seuros/epdiy-esp-idf-6/hardware/epaper-breakout/tp4056/charger_stepup.kicad_pcb

## KiCad design hardware/epaper-breakout/tp4056/charger_stepup.kicad_pcb (2025-03-20)

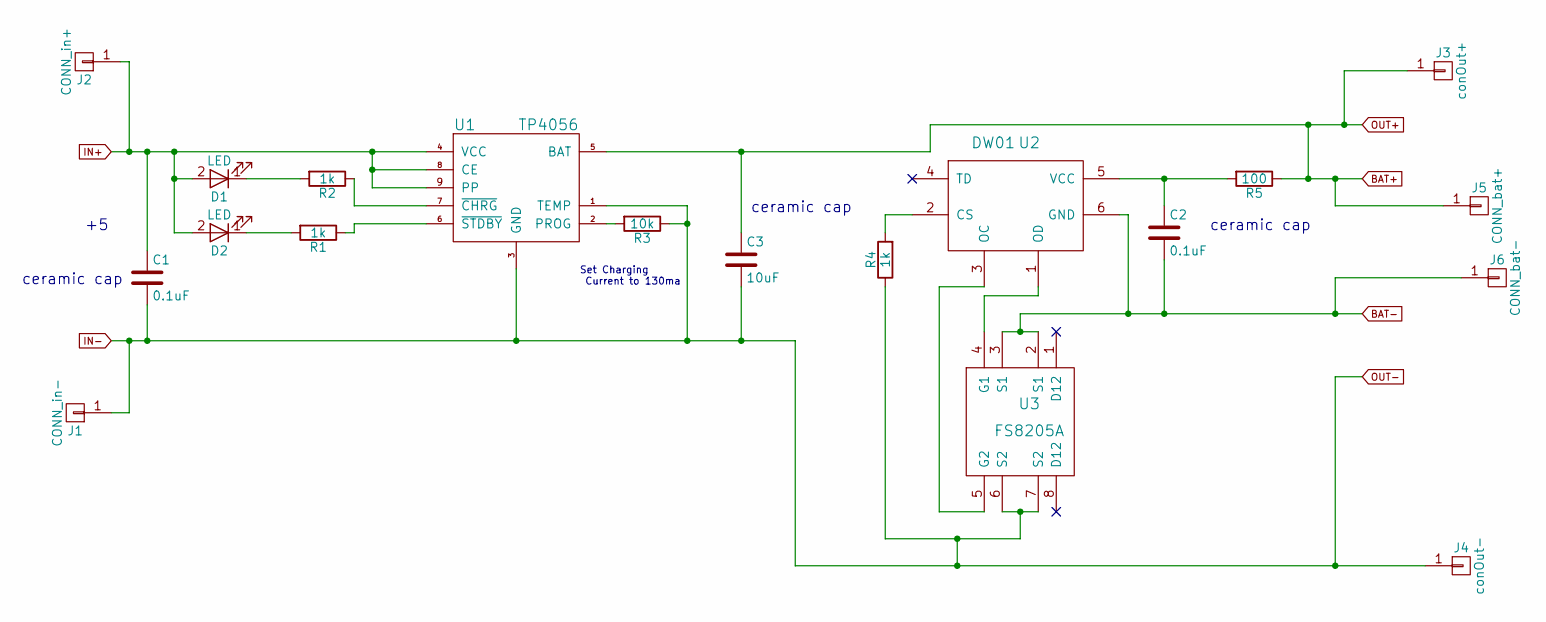
[picture p1: schematic charger_stepup.sch]

Parts:
C1, C2: 0.1uF; C_0805_HandSoldering
C3: 10uF; C_0805_HandSoldering
D1, D2: LED; LED_0603_HandSoldering
J1: CONN_in-; Pin_Header_Straight_1x01_Pitch2.54mm
J2: CONN_in+; Pin_Header_Straight_1x01_Pitch2.54mm
J3: conOut+; Pin_Header_Straight_1x01_Pitch2.54mm
J4: conOut-; Pin_Header_Straight_1x01_Pitch2.54mm
J5: CONN_bat+; Pin_Header_Straight_1x01_Pitch2.54mm
J6: CONN_bat-; Pin_Header_Straight_1x01_Pitch2.54mm
R1, R2, R4: 1k; R_0603_HandSoldering
R3: 10k; R_0603_HandSoldering
R5: 100; R_0603_HandSoldering
U1: TP4056; TP4056_SOP-8-PP
U2: DW01; SOT-23-6_Handsoldering
U3: FS8205A; TSSOP-8_4.4x3mm_Pitch0.65mm

Connections:
BAT+: C3.1, J3.1, J5.1, R5.1, U1.5 (BAT)
BAT-: C2.2, J6.1, U2.6 (GND), U3.2 (S1), U3.3 (S1)
IN+: C1.1, D1.2 (A), D2.2 (A), J2.1, U1.4 (VCC), U1.8 (CE), U1.9 (PP)
IN-: C1.2, C3.2, J1.1, J4.1, R3.1, R4.1, U1.1 (TEMP), U1.3 (GND), U3.6 (S2), U3.7 (S2)
unnamed: C2.1, R5.2, U2.5 (VCC)
unnamed: D1.1 (K), R2.2
unnamed: D2.1 (K), R1.2
unnamed: R1.1, U1.6 (~STDBY)
unnamed: R2.1, U1.7 (~CHRG)
unnamed: R3.2, U1.2 (PROG)
unnamed: R4.2, U2.2 (CS)
unnamed: U2.1 (OD), U3.4 (G1)
unnamed: U2.3 (OC), U3.5 (G2)

Notes on the sheet:
Set Charging Current to 130ma
ceramic cap

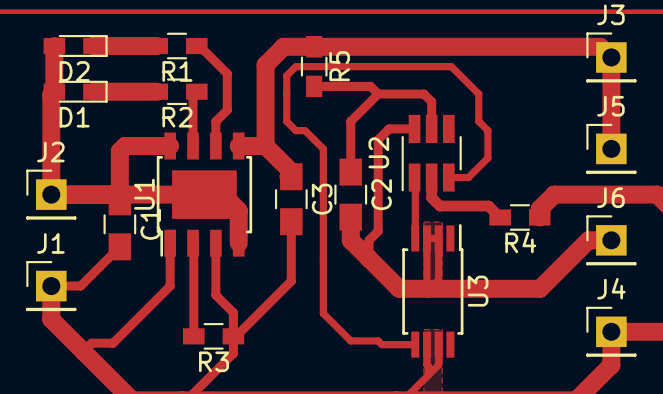
[picture p2: board charger_stepup.kicad_pcb from above]

Board: 2 copper layers, 19 parts (0 on the bottom side), 13 nets.
