seuros/epdiy-esp-idf-6/hardware/extension-40_to_PCB_test/extension-cable.kicad_pcb

## KiCad design hardware/extension-40_to_PCB_test/extension-cable.kicad_pcb (2023-10-25)

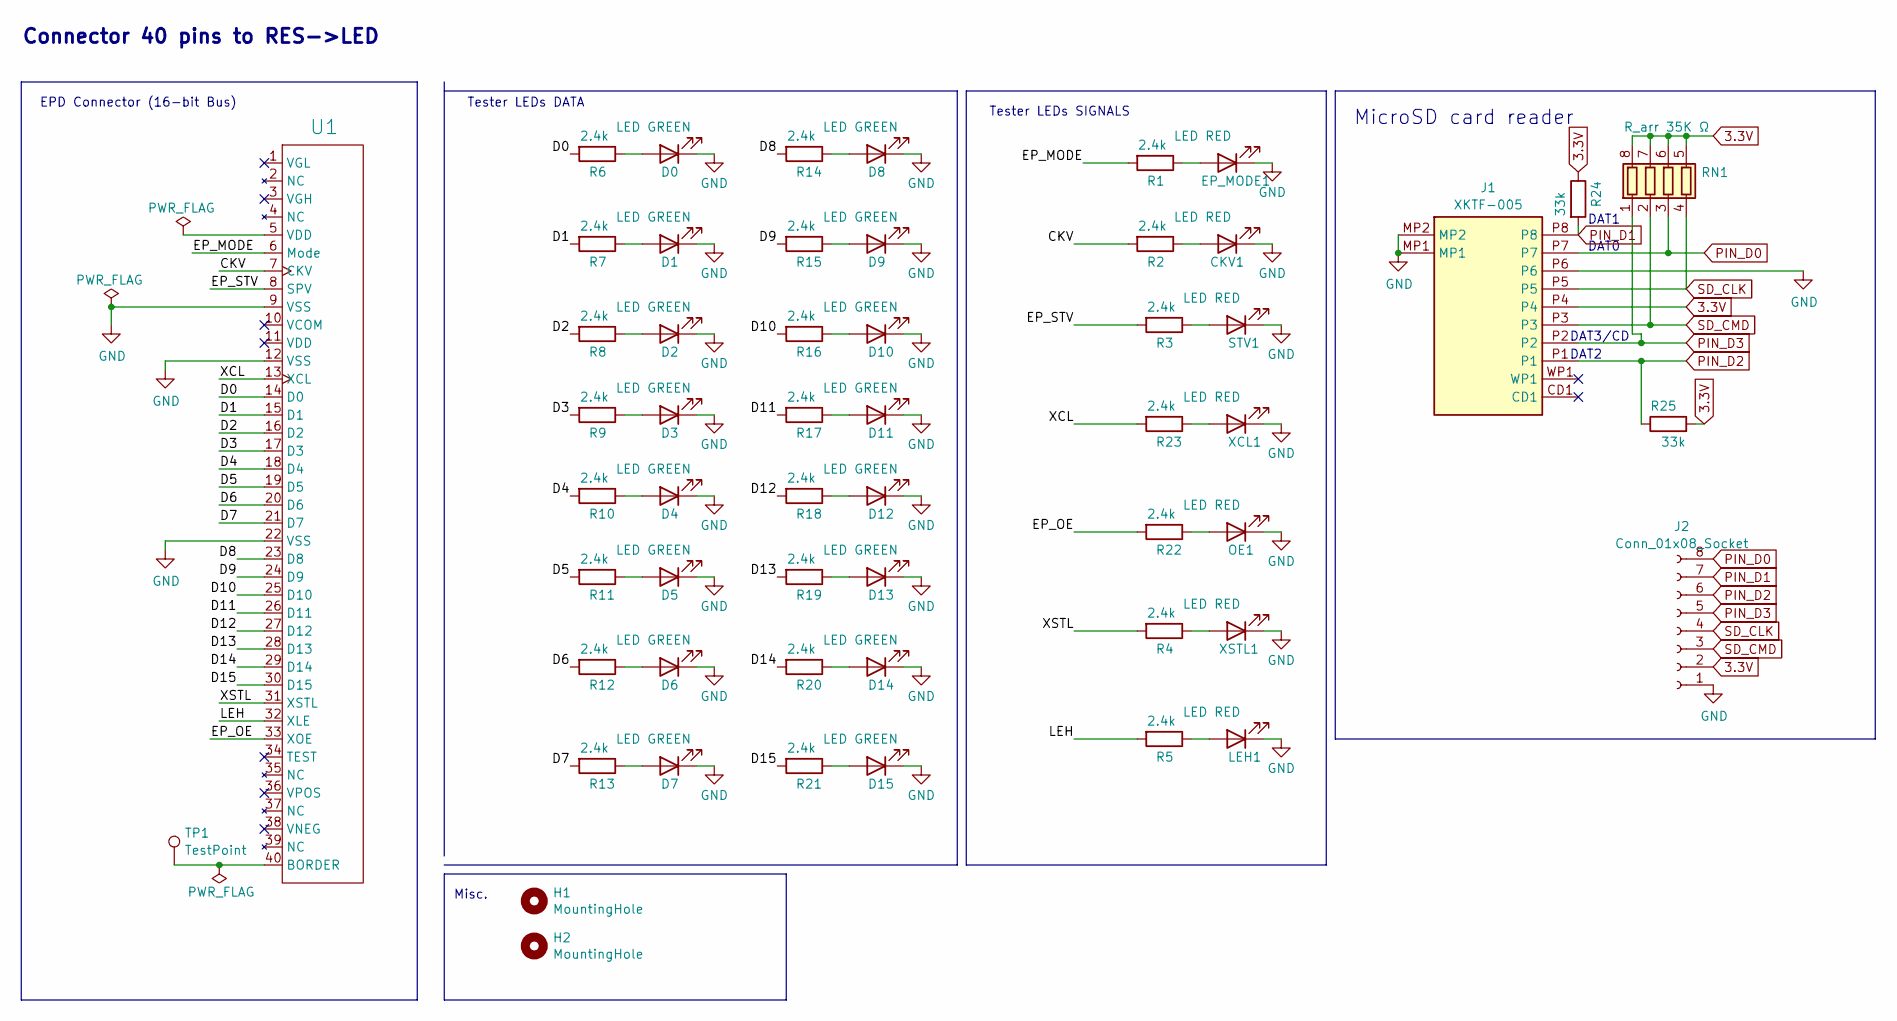
[picture p4: schematic extension-cable.kicad_sch, 40 pins to 16 bit signals tester (16 data IO + LEH,etc)]

Parts:
CKV1: LED RED; LED_0805_2012Metric; LCSC C84256
D0, D1, D2, D3, D4, D5, D6, D7, D8, D9, D10, D11, D12, D13, D14, D15: LED GREEN; LED_0805_2012Metric; LCSC C2297
EP_MODE1: LED RED; LED_0805_2012Metric; LCSC C84256
H1, H2: MountingHole; MountingHole_2.2mm_M2
J1: XKTF-005; XKTF005-SD; Manufacturer_Part_Number XKTF-005; LCSC C2689687
J2: Conn_01x08_Socket; PinSocket_1x08_P2.54mm_Vertical
LEH1: LED RED; LED_0805_2012Metric; LCSC C84256
OE1: LED RED; LED_0805_2012Metric; LCSC C84256
R1, R2, R3, R4, R5, R6, R7, R8, R9, R10, R11, R12, R13, R14, R15, R16, R17, R18, R19, R20, R21, R22, R23: 2.4k; R_0603_1608Metric; LCSC C22940
R24, R25: 33k; R_0603_1608Metric; LCSC C4216
RN1: R_arr 35K Ω; SMT_F392JTCE_UNR_SD-pullup; LCSC C425297
STV1: LED RED; LED_0805_2012Metric; LCSC C84256
TP1: TestPoint; TestPoint_Pad_2.0x2.0mm
U1: ED078KH6; FH1240S05SH55; LCSC C202114
XCL1: LED RED; LED_0805_2012Metric; LCSC C84256
XSTL1: LED RED; LED_0805_2012Metric; LCSC C84256

Connections:
3.3V: J1.P4, J2.2, R24.1, R25.2, RN1.5 (R4.2), RN1.6 (R3.2), RN1.7 (R2.2), RN1.8 (R1.2)
/CKV: R2.2, U1.7 (CKV)
/D0: R6.2, U1.14 (D0)
/D1: R7.2, U1.15 (D1)
/D2: R8.2, U1.16 (D2)
/D3: R9.2, U1.17 (D3)
/D4: R10.2, U1.18 (D4)
/D5: R11.2, U1.19 (D5)
/D6: R12.2, U1.20 (D6)
/D7: R13.2, U1.21 (D7)
/D8: R14.2, U1.23 (D8)
/D9: R15.2, U1.24 (D9)
/D10: R16.2, U1.25 (D10)
/D11: R17.2, U1.26 (D11)
/D12: R18.2, U1.27 (D12)
/D13: R19.2, U1.28 (D13)
/D14: R20.2, U1.29 (D14)
/D15: R21.2, U1.30 (D15)
/EP_MODE: R1.2, U1.6 (Mode)
/EP_OE: R22.2, U1.33 (XOE)
/EP_STV: R3.2, U1.8 (SPV)
/LEH: R5.2, U1.32 (XLE)
/XCL: R23.2, U1.13 (XCL)
/XSTL: R4.2, U1.31 (XSTL)
unnamed: CKV1.2 (A), R2.1
unnamed: D0.2 (A), R6.1
unnamed: D1.2 (A), R7.1
unnamed: D2.2 (A), R8.1
unnamed: D3.2 (A), R9.1
unnamed: D4.2 (A), R10.1
unnamed: D5.2 (A), R11.1
unnamed: D6.2 (A), R12.1
unnamed: D7.2 (A), R13.1
unnamed: D8.2 (A), R14.1
unnamed: D9.2 (A), R15.1
unnamed: D10.2 (A), R16.1
unnamed: D11.2 (A), R17.1
unnamed: D12.2 (A), R18.1
unnamed: D13.2 (A), R19.1
unnamed: D14.2 (A), R20.1
unnamed: D15.2 (A), R21.1
unnamed: EP_MODE1.2 (A), R1.1
unnamed: LEH1.2 (A), R5.1
unnamed: OE1.2 (A), R22.1
unnamed: R3.1, STV1.2 (A)
unnamed: R23.1, XCL1.2 (A)
unnamed: R4.1, XSTL1.2 (A)
PIN_D0: J1.P7, J2.8, RN1.3 (R3.1)
PIN_D1: J1.P8, J2.7, R24.2
PIN_D2: J1.P1, J2.6, R25.1
PIN_D3: J1.P2, J2.5, RN1.1 (R1.1)
SD_CLK: J1.P5, J2.4, RN1.4 (R4.1)
SD_CMD: J1.P3, J2.3, RN1.2 (R2.1)

Notes on the sheet:
DAT0
Tester LEDs SIGNALS
MicroSD card reader
Misc.
Tester LEDs DATA
Connector 40 pins to RES->LED
EPD Connector (16-bit Bus)
DAT1
DAT3/CD
DAT2

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
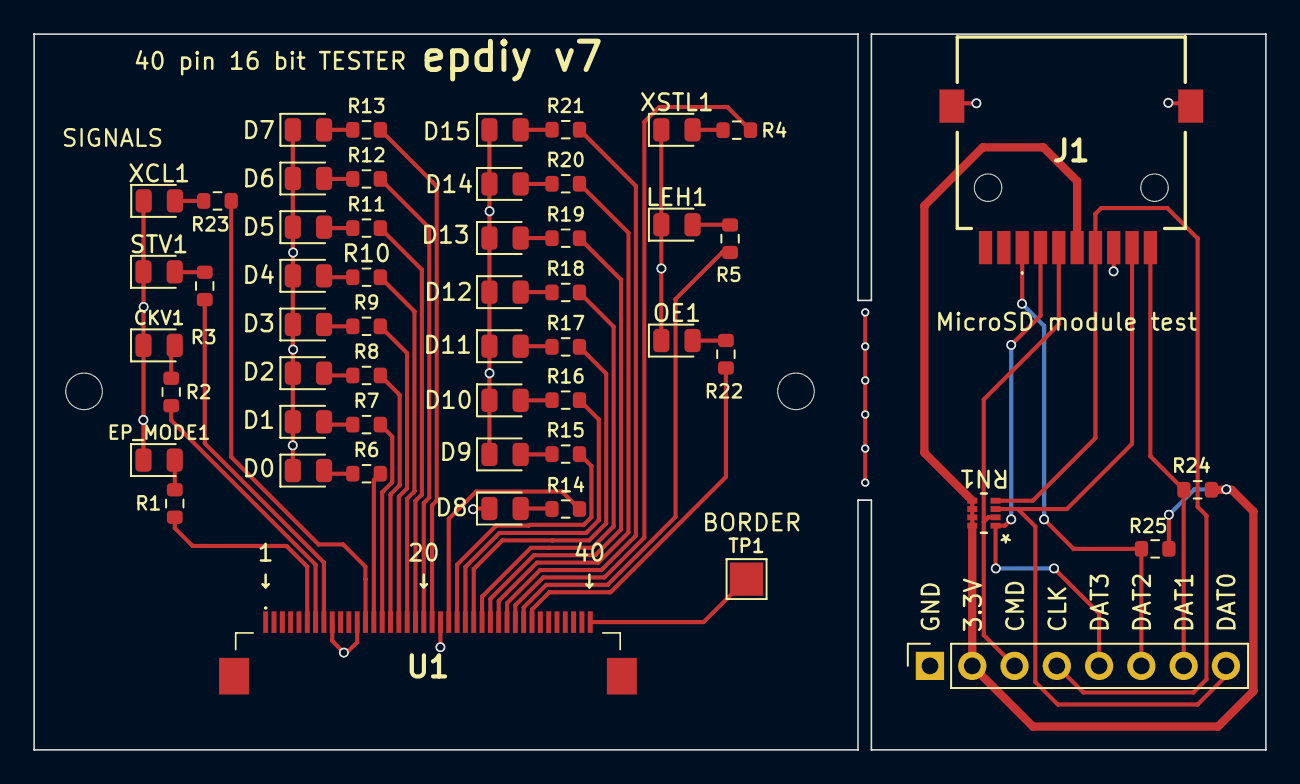
[picture p5: board hardware/extension-40_to_PCB_test/extension-cable.kicad_pcb from above]

Board: 2 copper layers, 74.0 x 43.0 mm, 55 parts (0 on the bottom side), 55 nets.
