seuros/epdiy-esp-idf-6/hardware/extension-9_40_to_34_6inch/extension-cable.kicad_pcb

## KiCad design hardware/extension-9_40_to_34_6inch/extension-cable.kicad_pcb (2023-10-24)

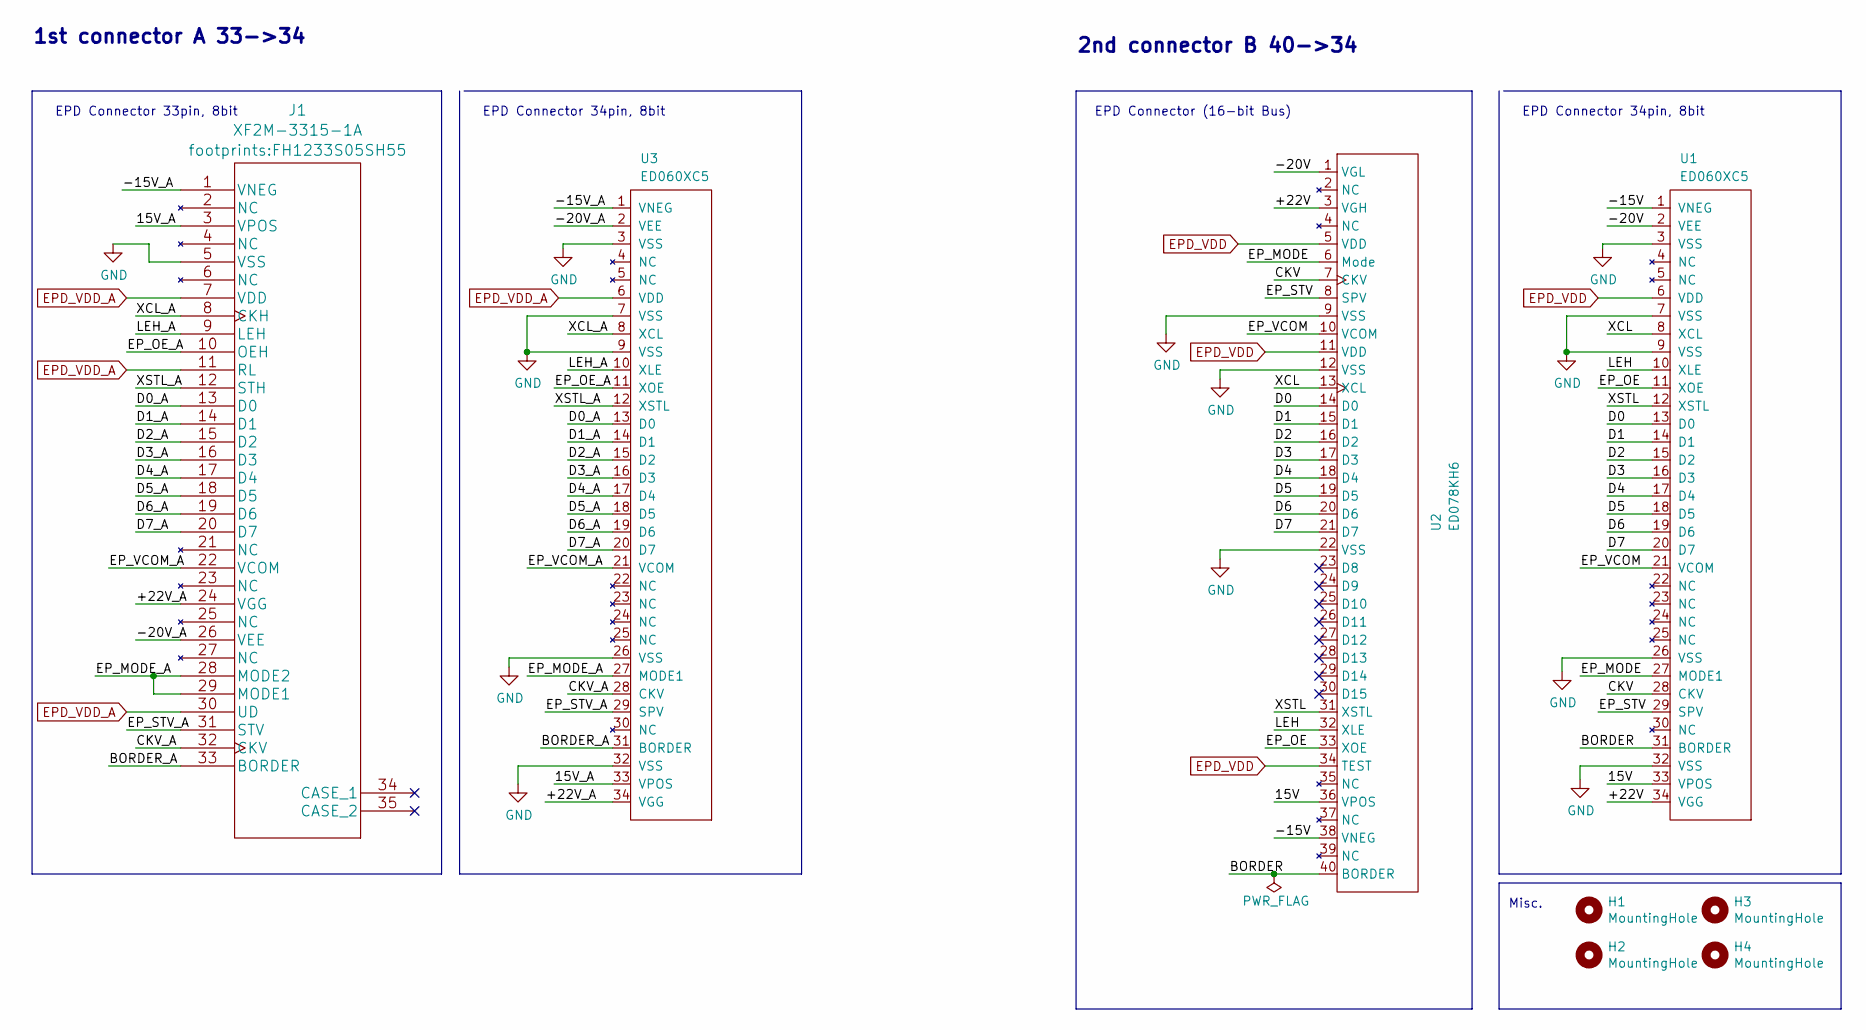
[picture p6: schematic extension-cable.kicad_sch, 33 pin 097 to 34 pin 060 adapter]

Parts:
H1, H2, H3, H4: MountingHole; MountingHole_2.2mm_M2
J1: XF2M-3315-1A; FH1233S05SH55; LCSC C597986
U1, U3: ED060XC5; X05A20H34G; LCSC C528053
U2: ED078KH6; FH1240S05SH55; LCSC C202114

Connections:
/15V: U1.33 (VPOS), U2.36 (VPOS)
/15V_A: J1.3 (VPOS), U3.33 (VPOS)
/+22V: U1.34 (VGG), U2.3 (VGH)
/+22V_A: J1.24 (VGG), U3.34 (VGG)
/-15V: U1.1 (VNEG), U2.38 (VNEG)
/-15V_A: J1.1 (VNEG), U3.1 (VNEG)
/-20V: U1.2 (VEE), U2.1 (VGL)
/-20V_A: J1.26 (VEE), U3.2 (VEE)
/BORDER: U1.31 (BORDER), U2.40 (BORDER)
/BORDER_A: J1.33 (BORDER), U3.31 (BORDER)
/CKV: U1.28 (CKV), U2.7 (CKV)
/CKV_A: J1.32 (CKV), U3.28 (CKV)
/D0: U1.13 (D0), U2.14 (D0)
/D0_A: J1.13 (D0), U3.13 (D0)
/D1: U1.14 (D1), U2.15 (D1)
/D1_A: J1.14 (D1), U3.14 (D1)
/D2: U1.15 (D2), U2.16 (D2)
/D2_A: J1.15 (D2), U3.15 (D2)
/D3: U1.16 (D3), U2.17 (D3)
/D3_A: J1.16 (D3), U3.16 (D3)
/D4: U1.17 (D4), U2.18 (D4)
/D4_A: J1.17 (D4), U3.17 (D4)
/D5: U1.18 (D5), U2.19 (D5)
/D5_A: J1.18 (D5), U3.18 (D5)
/D6: U1.19 (D6), U2.20 (D6)
/D6_A: J1.19 (D6), U3.19 (D6)
/D7: U1.20 (D7), U2.21 (D7)
/D7_A: J1.20 (D7), U3.20 (D7)
/EP_MODE: U1.27 (MODE1), U2.6 (Mode)
/EP_MODE_A: J1.28 (MODE2), J1.29 (MODE1), U3.27 (MODE1)
/EP_OE: U1.11 (XOE), U2.33 (XOE)
/EP_OE_A: J1.10 (OEH), U3.11 (XOE)
/EP_STV: U1.29 (SPV), U2.8 (SPV)
/EP_STV_A: J1.31 (STV), U3.29 (SPV)
/EP_VCOM: U1.21 (VCOM), U2.10 (VCOM)
/EP_VCOM_A: J1.22 (VCOM), U3.21 (VCOM)
/LEH: U1.10 (XLE), U2.32 (XLE)
/LEH_A: J1.9 (LEH), U3.10 (XLE)
/XCL: U1.8 (XCL), U2.13 (XCL)
/XCL_A: J1.8 (CKH), U3.8 (XCL)
/XSTL: U1.12 (XSTL), U2.31 (XSTL)
/XSTL_A: J1.12 (STH), U3.12 (XSTL)
EPD_VDD: U1.6 (VDD), U2.5 (VDD), U2.11 (VDD), U2.34 (TEST)
EPD_VDD_A: J1.7 (VDD), J1.11 (RL), J1.30 (UD), U3.6 (VDD)
GND: J1.5 (VSS), U1.3 (VSS), U1.7 (VSS), U1.9 (VSS), U1.26 (VSS), U1.32 (VSS), U2.9 (VSS), U2.12 (VSS), U2.22 (VSS), U3.3 (VSS), U3.7 (VSS), U3.9 (VSS), U3.26 (VSS), U3.32 (VSS)

Notes on the sheet:
1st connector A 33->34
Misc.
EPD Connector 33pin, 8bit
EPD Connector 34pin, 8bit
2nd connector B 40->34
EPD Connector (16-bit Bus)

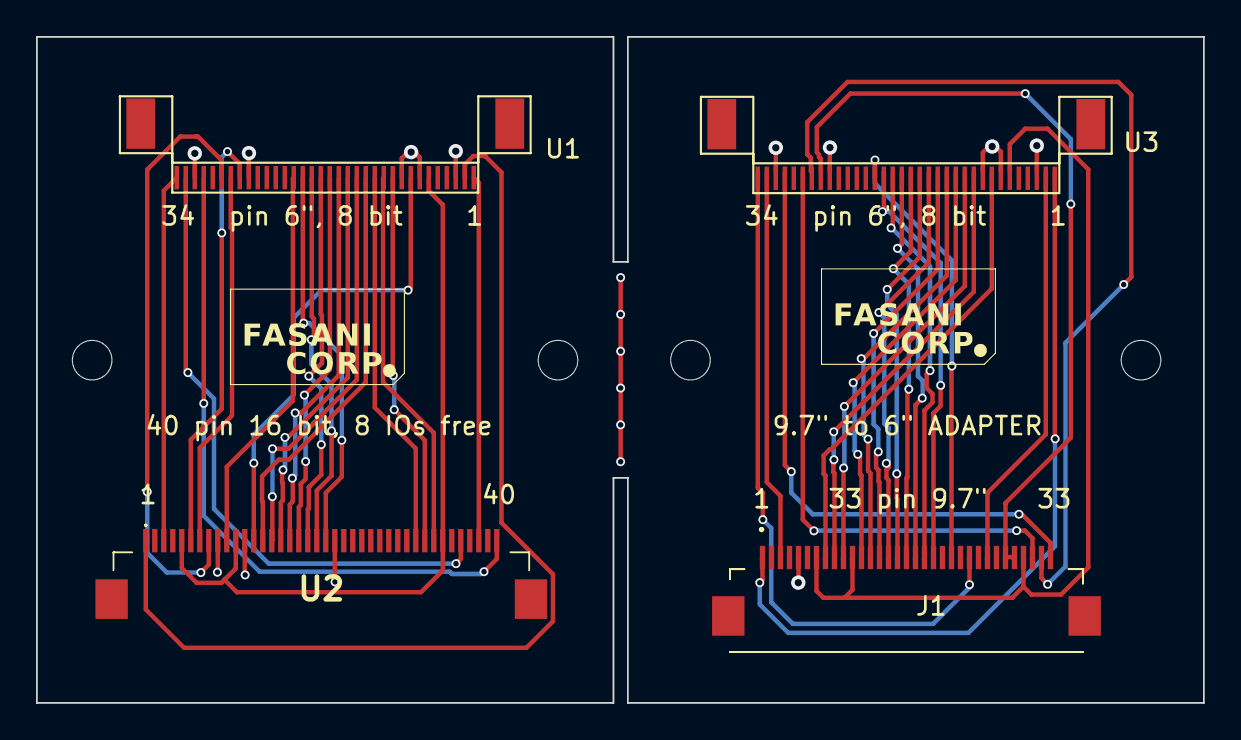
[picture p7: board hardware/extension-9_40_to_34_6inch/extension-cable.kicad_pcb from above]

Board: 2 copper layers, 64.8 x 37.0 mm, 8 parts (0 on the bottom side), 45 nets.
