seuros/epdiy-esp-idf-6/hardware/epaper-breakout/epaper-breakout.kicad_pcb

## KiCad design hardware/epaper-breakout/epaper-breakout.kicad_pcb (2023-07-07)

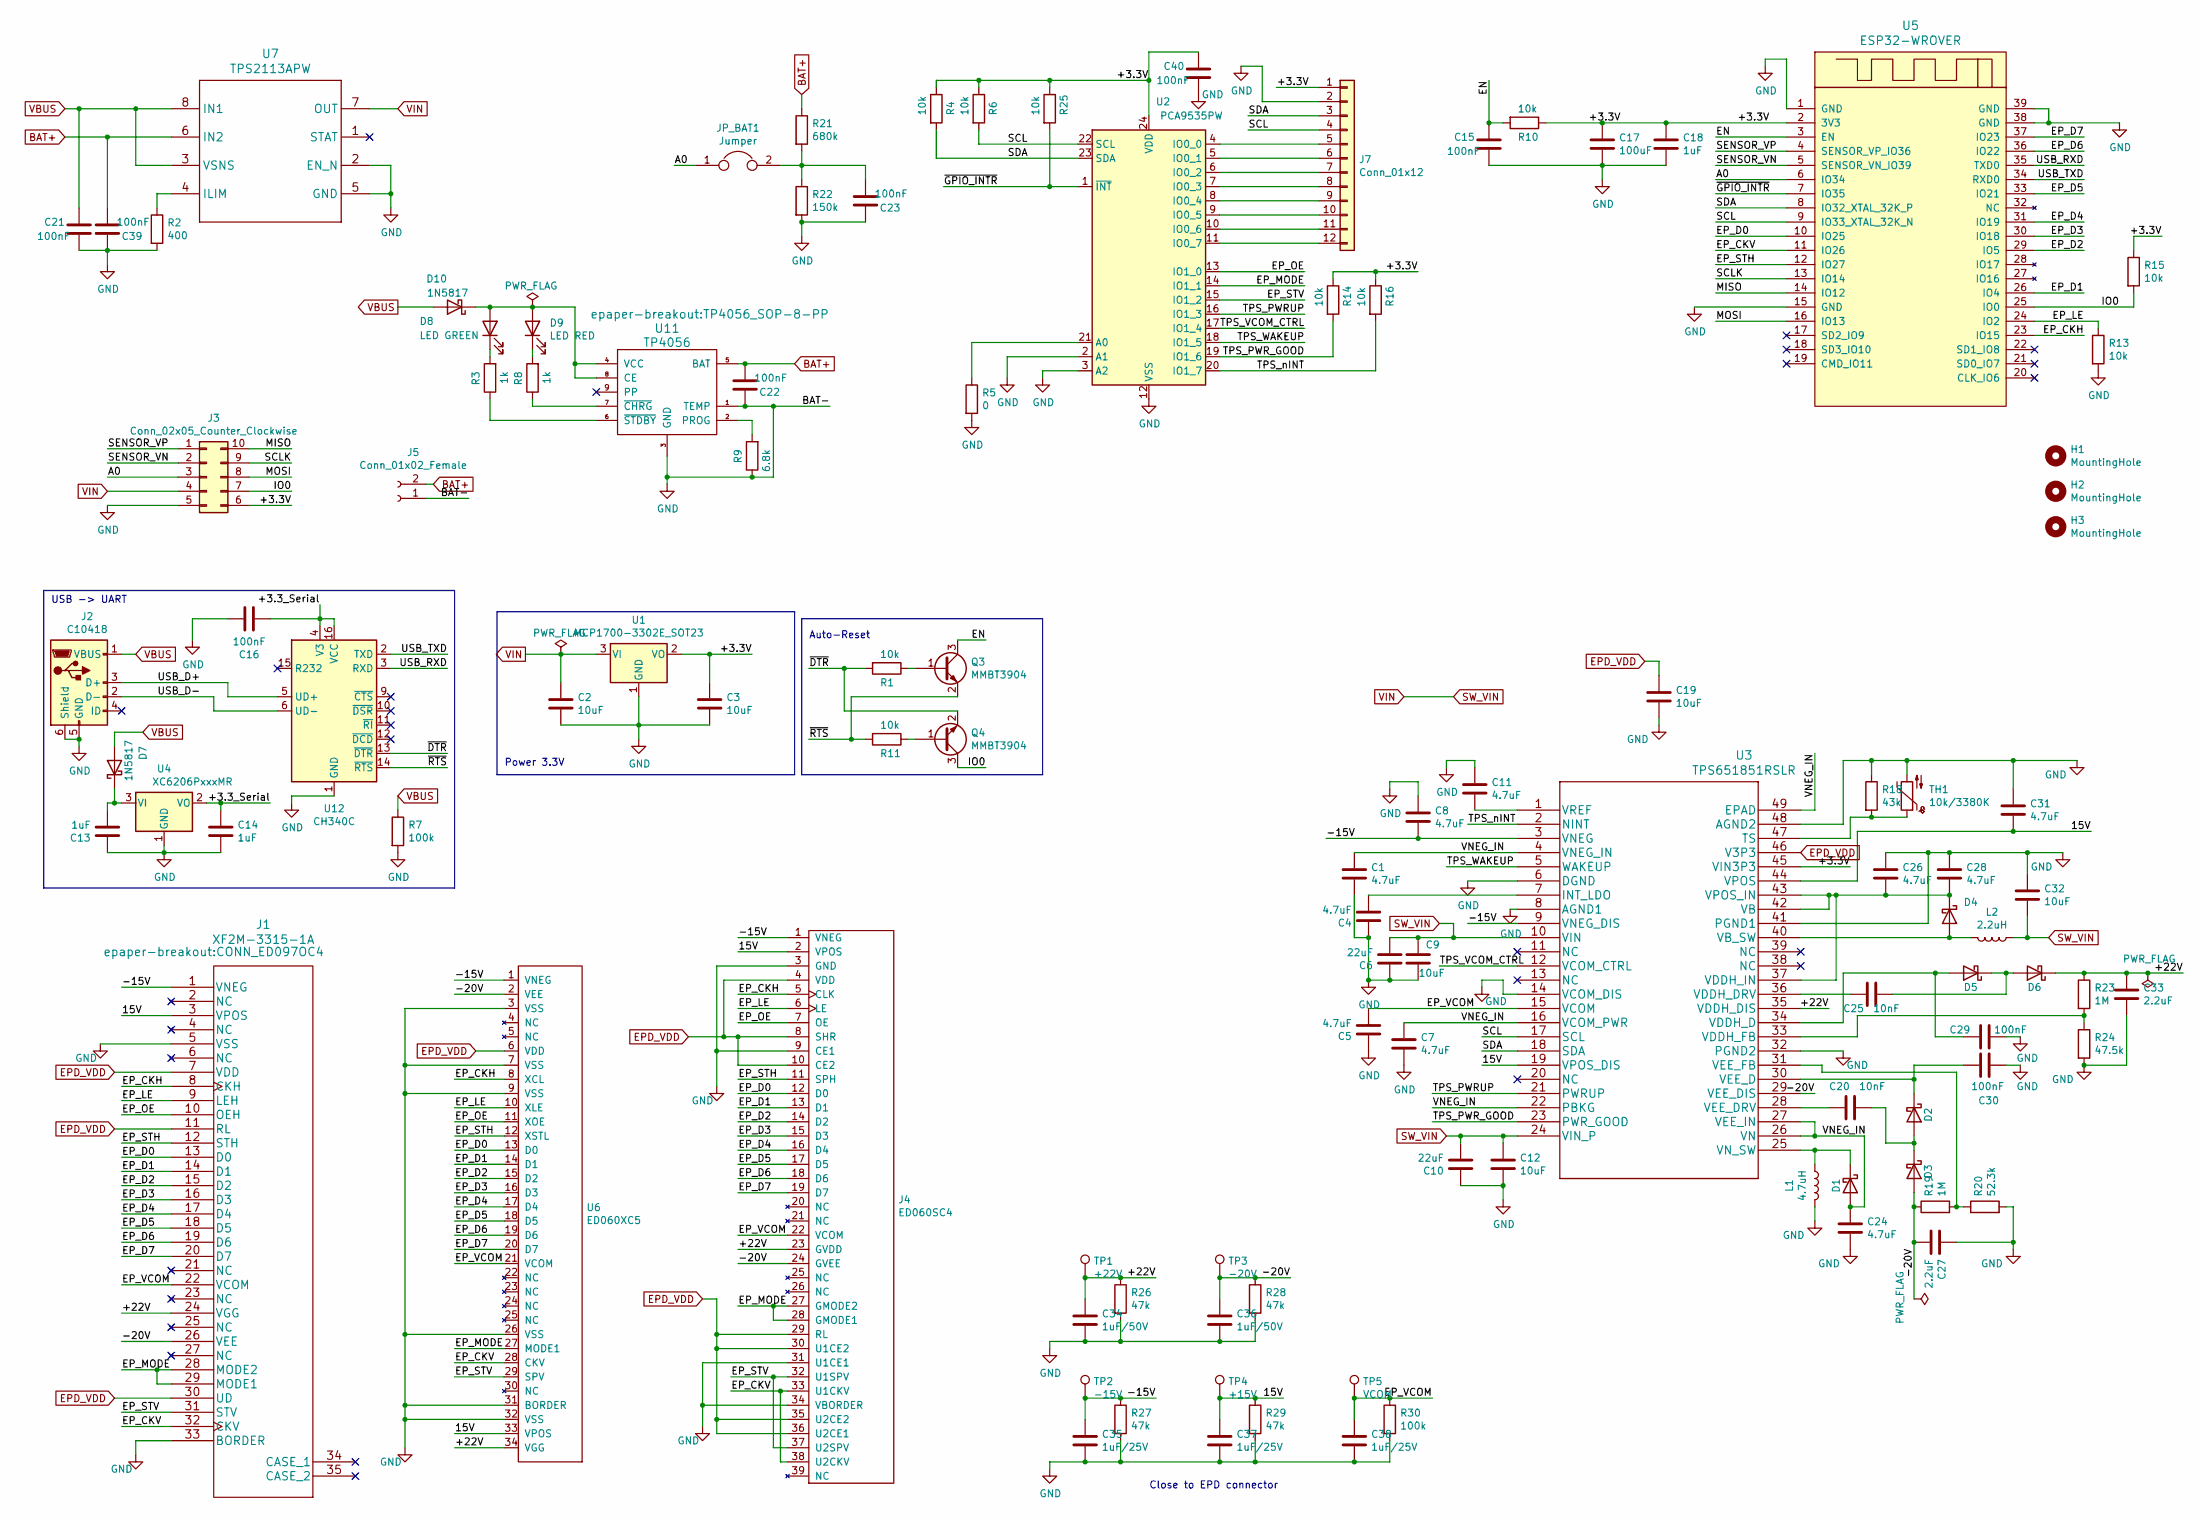
[picture p8: schematic epaper-breakout.kicad_sch, epdiy]

Parts:
C1, C4, C5, C7, C8, C11, C24, C26, C28, C31: 4.7uF; C_0805_2012Metric; LCSC C1779
C2, C3, C9, C12, C32: 10uF; C_0805_2012Metric; LCSC C15850
C6, C10: 22uF; C_0805_2012Metric; LCSC C45783
C13, C14, C18: 1uF; C_0805_2012Metric; LCSC C28323
C15, C16, C21, C22, C23, C29, C30, C39, C40: 100nF; C_0805_2012Metric; LCSC C49678
C17: 100uF; CP_EIA-3528-15_AVX-H; LCSC C16133
C19: 10uF; C_0805_2012Metric; LCSC C19702
C20, C25: 10nF; C_0805_2012Metric; LCSC C1710
C27, C33: 2.2uF; C_0805_2012Metric; LCSC C49217
C34, C36: 1uF/50V; C_1206_3216Metric; LCSC C1848
C35, C37, C38: 1uF/25V; C_0805_2012Metric; LCSC C28323
D1, D2, D3, D4, D5, D6: MBR0540; D_SOD-123; LCSC C21353
D7, D10: 1N5817; D_SOD-123; LCSC C8598
D8: LED GREEN; LED_0805_2012Metric; LCSC C2297
D9: LED RED; LED_0805_2012Metric; LCSC C84256
H1, H2, H3: MountingHole; MountingHole_2.2mm_M2
J1: XF2M-3315-1A; CONN_ED097OC4; LCSC C231420
J2: C10418; USB_Micro-B_A01SB141B1-067; LCSC C10418
J3: Conn_02x05_Counter_Clockwise; PinHeader_2x05_P2.54mm_Vertical
J4: ED060SC4; HRS_FH26W-39S-0.3SHW(60); LCSC C519255
J5: Conn_01x02_Female; PinHeader_1x02_P2.54mm_Vertical
J7: Conn_01x12; PinHeader_2x06_P2.54mm_Vertical
JP_BAT1: Jumper; SolderJumper-2_P1.3mm_Bridged2Bar_RoundedPad1.0x1.5mm
L1: 4.7uH; L_Taiyo-Yuden_NR-50xx_HandSoldering; LCSC C222947
L2: 2.2uH; L_Taiyo-Yuden_NR-40xx_HandSoldering; LCSC C92959
Q3, Q4: MMBT3904; SOT-23; LCSC C20526
R1, R4, R6, R10, R11, R13, R14, R15, R16, R25: 10k; R_0603_1608Metric; LCSC C25804
R2: 400; R_0603_1608Metric; LCSC C23151
R3, R8: 1k; R_0603_1608Metric; LCSC C21190
R5: 0; R_0603_1608Metric
R7, R30: 100k; R_0603_1608Metric; LCSC C25803
R9: 6.8k; R_0603_1608Metric; LCSC C23212
R18: 43k; R_0603_1608Metric; LCSC C23172
R19, R23: 1M; R_0603_1608Metric; LCSC C22935
R20: 52.3k; R_0603_1608Metric; LCSC C23196
R21: 680k; R_0603_1608Metric; LCSC C25822
R22: 150k; R_0603_1608Metric; LCSC C22807
R24: 47.5k; R_0603_1608Metric; LCSC C25819
R26, R27, R28, R29: 47k; R_0603_1608Metric; LCSC C25819
TH1: 10k/3380K; R_0603_1608Metric; LCSC C76589
TP1: +22V; TestPoint_Pad_D2.5mm
TP2: -15V; TestPoint_Pad_D2.5mm
TP3: -20V; TestPoint_Pad_D2.5mm
TP4: +15V; TestPoint_Pad_D2.5mm
TP5: VCOM; TestPoint_Pad_D2.5mm
U1: MCP1700-3302E_SOT23; SOT-23; LCSC C39051
U2: PCA9535PW; TSSOP-24_4.4x7.8mm_P0.65mm; LCSC C255606
U3: TPS651851RSLR; LCSC C139292
U4: XC6206PxxxMR; SOT-23; LCSC C5446
U5: ESP32-WROVER; LCSC C503591
U6: ED060XC5; X05A20H34G; LCSC C528053
U7: TPS2113APW; LCSC C130052
U11: TP4056; TP4056_SOP-8-PP; LCSC C16581
U12: CH340C; SOIC-16_3.9x9.9mm_P1.27mm; LCSC C84681

Connections:
/15V: C31.2, C37.1, J1.3 (VPOS), J4.2 (VPOS), R29.1, TP4.1, U3.19 (VPOS_DIS), U3.44 (VPOS), U6.33 (VPOS)
/+3.3V: C3.2, C17.1, C18.2, C40.1, J3.6, J7.1, R4.1, R6.1, R10.1, R14.1, R15.1, R16.1, R25.1, U1.2 (VO), U2.24 (VDD), U3.45 (VIN3P3), U5.2 (3V3)
/+3.3_Serial: C14.2, C16.1, U4.2 (VO), U12.4 (V3), U12.16 (VCC)
/+22V: C33.1, C34.1, D6.1 (K), J1.24 (VGG), J4.23 (GVDD), R23.1, R26.1, TP1.1, U3.35 (VDDH_DIS), U6.34 (VGG)
/-15V: C8.2, C35.1, J1.1 (VNEG), J4.1 (VNEG), R27.1, TP2.1, U3.3 (VNEG), U3.9 (VNEG_DIS), U6.1 (VNEG)
/-20V: C27.2, C36.1, D3.2 (A), J1.26 (VEE), J4.24 (GVEE), R19.1, R28.1, TP3.1, U3.29 (VEE_DIS), U6.2 (VEE)
/A0: J3.3, JP_BAT1.1, U5.6 (IO34)
/EN: C15.1, Q3.3 (C), R10.2, U5.3 (EN)
/EP_CKH: J1.8 (CKH), J4.5 (CLK), U5.23 (IO15), U6.8 (XCL)
/EP_CKV: J1.32 (CKV), J4.33 (U1CKV), J4.38 (U2CKV), U5.11 (IO26), U6.28 (CKV)
/EP_D0: J1.13 (D0), J4.12 (D0), U5.10 (IO25), U6.13 (D0)
/EP_D1: J1.14 (D1), J4.13 (D1), U5.26 (IO4), U6.14 (D1)
/EP_D2: J1.15 (D2), J4.14 (D2), U5.29 (IO5), U6.15 (D2)
/EP_D3: J1.16 (D3), J4.15 (D3), U5.30 (IO18), U6.16 (D3)
/EP_D4: J1.17 (D4), J4.16 (D4), U5.31 (IO19), U6.17 (D4)
/EP_D5: J1.18 (D5), J4.17 (D5), U5.33 (IO21), U6.18 (D5)
/EP_D6: J1.19 (D6), J4.18 (D6), U5.36 (IO22), U6.19 (D6)
/EP_D7: J1.20 (D7), J4.19 (D7), U5.37 (IO23), U6.20 (D7)
/EP_LE: J1.9 (LEH), J4.6 (LE), R13.1, U5.24 (IO2), U6.10 (XLE)
/EP_MODE: J1.28 (MODE2), J1.29 (MODE1), J4.27 (GMODE2), J4.28 (GMODE1), U2.14 (IO1_1), U6.27 (MODE1)
/EP_OE: J1.10 (OEH), J4.7 (OE), U2.13 (IO1_0), U6.11 (XOE)
/EP_STH: J1.12 (STH), J4.11 (SPH), U5.12 (IO27), U6.12 (XSTL)
/EP_STV: J1.31 (STV), J4.32 (U1SPV), J4.37 (U2SPV), U2.15 (IO1_2), U6.29 (SPV)
/EP_VCOM: C5.2, C38.1, J1.22 (VCOM), J4.22 (VCOM), R30.1, TP5.1, U3.15 (VCOM), U6.21 (VCOM)
/IO0: J3.7, Q4.3 (C), R15.2, U5.25 (IO0)
/MISO: J3.10, U5.14 (IO12)
/MOSI: J3.8, U5.16 (IO13)
/SCL: J7.4, R6.2, U2.22 (SCL), U3.17 (SCL), U5.9 (IO33_XTAL_32K_N)
/SCLK: J3.9, U5.13 (IO14)
/SDA: J7.3, R4.2, U2.23 (SDA), U3.18 (SDA), U5.8 (IO32_XTAL_32K_P)
/SENSOR_VN: J3.2, U5.5 (SENSOR_VN_IO39)
/SENSOR_VP: J3.1, U5.4 (SENSOR_VP_IO36)
/TPS_PWRUP: U2.16 (IO1_3), U3.21 (PWRUP)
/TPS_PWR_GOOD: R14.2, U2.19 (IO1_6), U3.23 (PWR_GOOD)
/TPS_VCOM_CTRL: U2.17 (IO1_4), U3.12 (VCOM_CTRL)
/TPS_WAKEUP: U2.18 (IO1_5), U3.5 (WAKEUP)
/TPS_nINT: R16.2, U2.20 (IO1_7), U3.2 (NINT)
/USB_D+: J2.3 (D+), U12.5 (UD+)
/USB_D-: J2.2 (D-), U12.6 (UD-)
/USB_RXD: U5.35 (TXD0), U12.3 (RXD)
/USB_TXD: U5.34 (RXD0), U12.2 (TXD)
/VNEG_IN: C1.1, C7.1, C24.1, D1.2 (A), U3.4 (VNEG_IN), U3.16 (VCOM_PWR), U3.22 (PBKG), U3.26 (VN), U3.27 (VEE_IN), U3.49 (EPAD)
/~DTR: Q4.2 (E), R1.2, U12.13 (~DTR)
/~GPIO_INTR: R25.2, U2.1 (~INT), U5.7 (IO35)
/~RTS: Q3.2 (E), R11.2, U12.14 (~RTS)
BAT+: C22.2, C39.2, J5.2, R21.1, U7.6 (IN2), U11.5 (BAT)
EPD_VDD: C19.1, J1.7 (VDD), J1.11 (RL), J1.30 (UD), J4.4 (VDD), J4.8 (SHR), J4.10 (CE2), J4.29 (RL), J4.30 (U1CE2), J4.35 (U2CE2), J4.36 (U2CE1), U3.46 (V3P3), U6.6 (VDD)
GND: C1.2, C2.1, C3.1, C4.1, C5.1, C6.1, C7.2, C8.1, C9.2, C10.1, C11.1, C12.2, C13.2, C14.1, C15.2, C16.2, C17.2, C18.1, C19.2, C21.2, C22.1, C23.1, C24.2, C26.1, C27.1, C28.1, C29.1, C30.2, C31.1, C32.1, C33.2, C34.2, C35.2, C36.2, C37.2, C38.2, C39.1, C40.2, J1.5 (VSS), J1.33 (BORDER), J2.5 (GND), J2.6 (Shield), J3.5, J4.3 (GND), J4.9 (CE1), J4.31 (U1CE1), J4.34 (VBORDER), J5.1, J7.2, L1.2, R2.2, R5.2, R7.2, R9.1, R13.2, R18.1, R20.2, R22.2, R24.2, R26.2, R27.2, R28.2, R29.2, R30.2, TH1.2, U1.1 (GND), U2.2 (A1), U2.3 (A2), U2.12 (VSS), U3.6 (DGND), U3.8 (AGND1), U3.14 (VCOM_DIS), U3.32 (PGND2), U3.41 (PGND1), U3.48 (AGND2), U4.1 (GND), U5.1 (GND), U5.15 (GND), U5.38 (GND), U5.39 (GND), U6.3 (VSS), U6.7 (VSS), U6.9 (VSS), U6.26 (VSS), U6.31 (BORDER), U6.32 (VSS), U7.2 (EN_N), U7.5 (GND), U11.1 (TEMP), U11.3 (GND), U12.1 (GND)
unnamed: C4.2, U3.7 (INT_LDO)
unnamed: C11.2, U3.1 (VREF)
unnamed: C13.1, D7.1 (K), U4.3 (VI)
unnamed: C20.1, D2.2 (A), D3.1 (K)
unnamed: C20.2, U3.28 (VEE_DRV)
unnamed: C23.2, JP_BAT1.2, R21.2, R22.1
unnamed: C25.1, D5.1 (K), D6.2 (A)
unnamed: C25.2, U3.36 (VDDH_DRV)
unnamed: C26.2, C28.2, D4.1 (K), U3.37 (VDDH_IN), U3.42 (VB), U3.43 (VPOS_IN)
unnamed: C29.2, D5.2 (A), U3.34 (VDDH_D)
unnamed: C30.1, D2.1 (K), U3.30 (VEE_D)
unnamed: D1.1 (K), L1.1, U3.25 (VN_SW)
unnamed: D4.2 (A), L2.2, U3.40 (VB_SW)
unnamed: D8.1 (K), R3.2
unnamed: D9.1 (K), R8.2
unnamed: D8.2 (A), D9.2 (A), D10.1 (K), U11.4 (VCC), U11.8 (CE)
unnamed: J7.5, U2.4 (IO0_0)
unnamed: J7.6, U2.5 (IO0_1)
unnamed: J7.7, U2.6 (IO0_2)
unnamed: J7.8, U2.7 (IO0_3)
unnamed: J7.9, U2.8 (IO0_4)
unnamed: J7.10, U2.9 (IO0_5)
unnamed: J7.11, U2.10 (IO0_6)
unnamed: J7.12, U2.11 (IO0_7)
unnamed: Q3.1 (B), R1.1
unnamed: Q4.1 (B), R11.1
unnamed: R2.1, U7.4 (ILIM)
unnamed: R3.1, U11.6 (~STDBY)
unnamed: R5.1, U2.21 (A0)
unnamed: R8.1, U11.7 (~CHRG)
unnamed: R9.2, U11.2 (PROG)
unnamed: R18.2, TH1.1, U3.47 (TS)
unnamed: R19.2, R20.1, U3.31 (VEE_FB)
unnamed: R23.2, R24.1, U3.33 (VDDH_FB)
SW_VIN: C2.2, C6.2, C9.1, C10.2, C12.1, C32.2, J3.4, L2.1, U1.3 (VI), U3.10 (VIN), U3.24 (VIN_P), U7.7 (OUT)
VBUS: C21.1, D7.2 (A), D10.2 (A), J2.1 (VBUS), R7.1, U7.3 (VSNS), U7.8 (IN1)

Notes on the sheet:
Power 3.3V
Auto-Reset
Close to EPD connector
USB -> UART

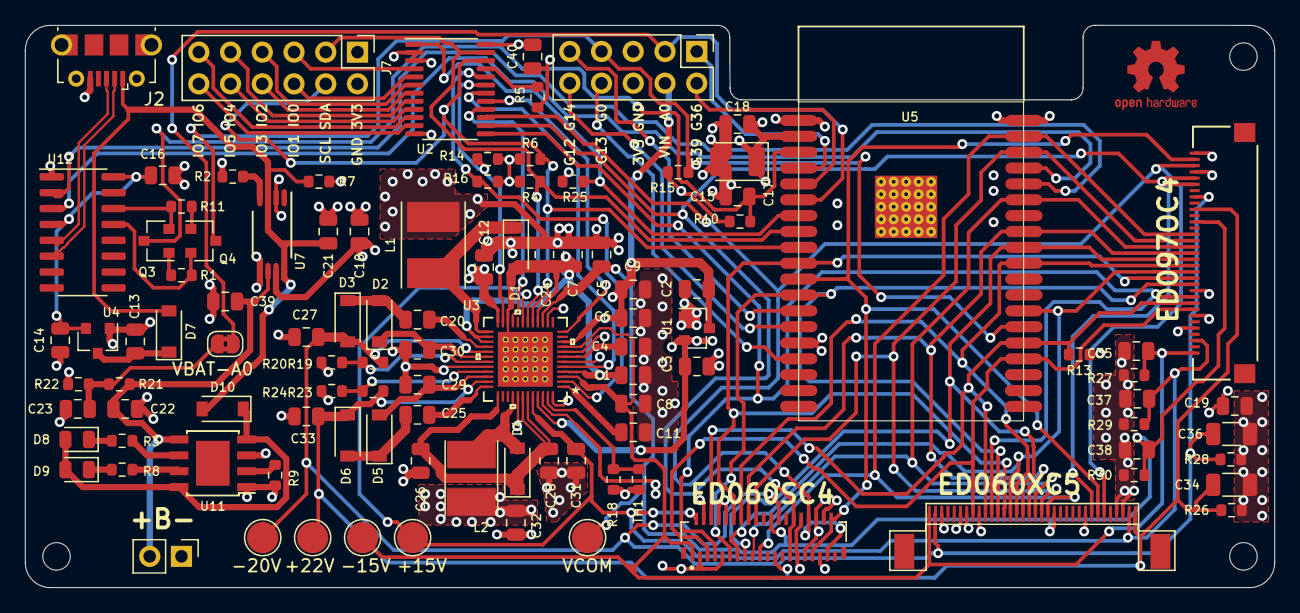
[picture p9: board hardware/epaper-breakout/epaper-breakout.kicad_pcb from above]

Board: 4 copper layers, 100.0 x 45.0 mm, 108 parts (1 on the bottom side), 84 nets.

Other parts of the board:
CC: Symbol_CreativeCommons_SilkScreenTop_Type2_Big
