seuros/epdiy-esp-idf-6/hardware/ES108FC1_Connector/ES108FC1_Connector.kicad_pcb

## KiCad design hardware/ES108FC1_Connector/ES108FC1_Connector.kicad_pcb (2023-07-07)

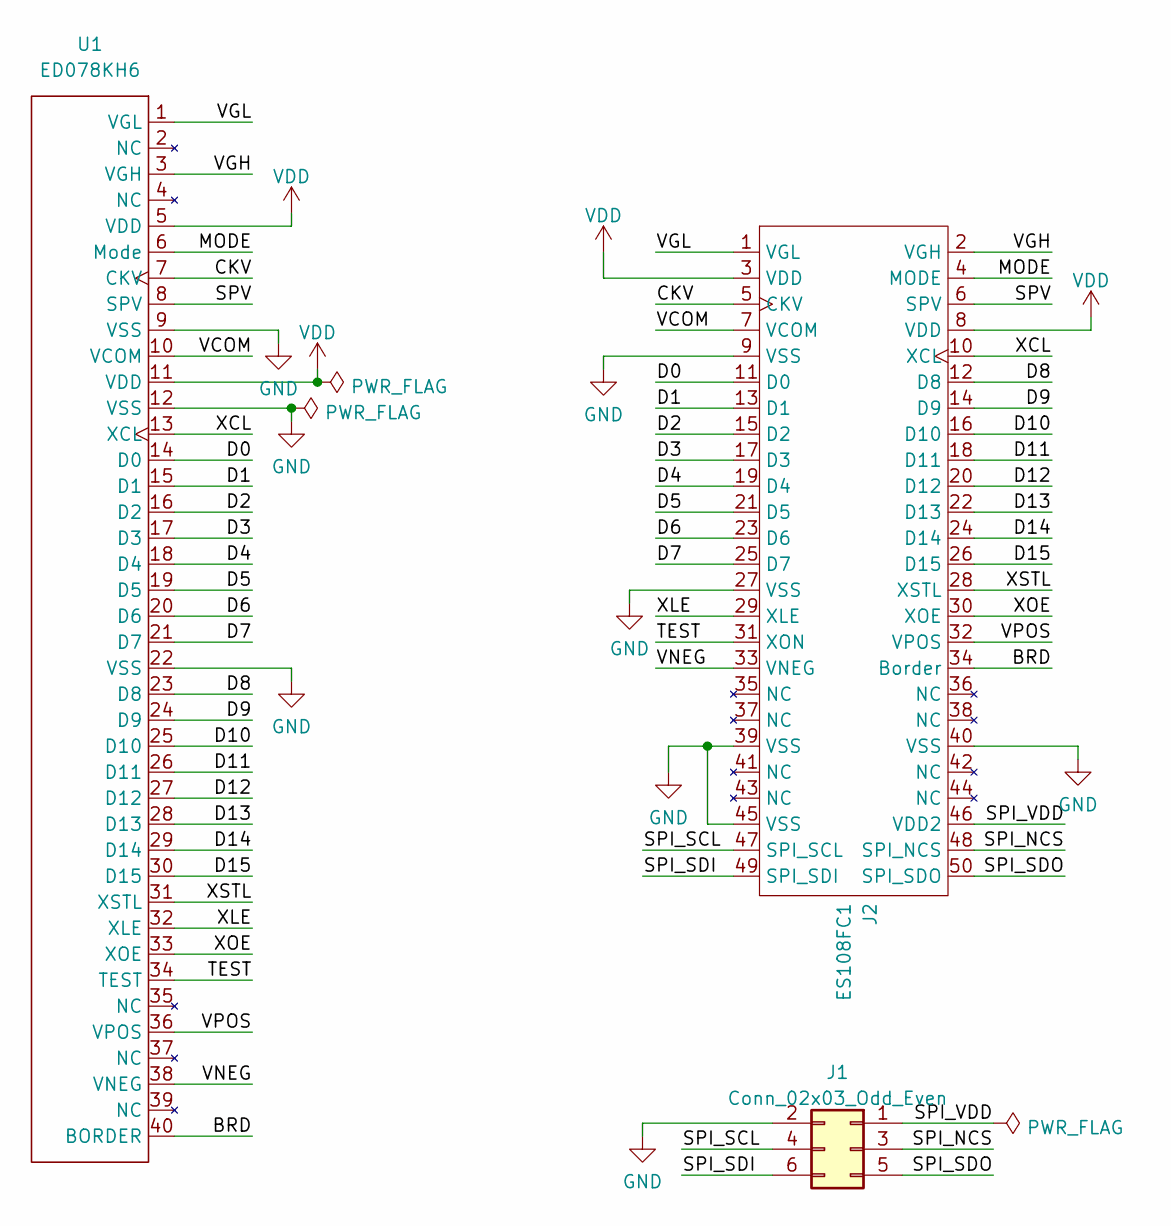
[picture p10: schematic ES108FC1_Connector.kicad_sch]

Parts:
J1: Conn_02x03_Odd_Even; PinHeader_2x03_P2.54mm_Vertical
J2: ES108FC1; LCSC C2880696
U1: ED078KH6; Hirose_FH12-40S-0.5SH_mirrored; LCSC C202114

Connections:
/BRD: J2.34 (Border), U1.40 (BORDER)
/CKV: J2.5 (CKV), U1.7 (CKV)
/D0: J2.11 (D0), U1.14 (D0)
/D1: J2.13 (D1), U1.15 (D1)
/D2: J2.15 (D2), U1.16 (D2)
/D3: J2.17 (D3), U1.17 (D3)
/D4: J2.19 (D4), U1.18 (D4)
/D5: J2.21 (D5), U1.19 (D5)
/D6: J2.23 (D6), U1.20 (D6)
/D7: J2.25 (D7), U1.21 (D7)
/D8: J2.12 (D8), U1.23 (D8)
/D9: J2.14 (D9), U1.24 (D9)
/D10: J2.16 (D10), U1.25 (D10)
/D11: J2.18 (D11), U1.26 (D11)
/D12: J2.20 (D12), U1.27 (D12)
/D13: J2.22 (D13), U1.28 (D13)
/D14: J2.24 (D14), U1.29 (D14)
/D15: J2.26 (D15), U1.30 (D15)
/MODE: J2.4 (MODE), U1.6 (Mode)
/SPI_NCS: J1.3, J2.48 (SPI_NCS)
/SPI_SCL: J1.4, J2.47 (SPI_SCL)
/SPI_SDI: J1.6, J2.49 (SPI_SDI)
/SPI_SDO: J1.5, J2.50 (SPI_SDO)
/SPI_VDD: J1.1, J2.46 (VDD2)
/SPV: J2.6 (SPV), U1.8 (SPV)
/TEST: J2.31 (XON), U1.34 (TEST)
/VCOM: J2.7 (VCOM), U1.10 (VCOM)
/VGH: J2.2 (VGH), U1.3 (VGH)
/VGL: J2.1 (VGL), U1.1 (VGL)
/VNEG: J2.33 (VNEG), U1.38 (VNEG)
/VPOS: J2.32 (VPOS), U1.36 (VPOS)
/XCL: J2.10 (XCL), U1.13 (XCL)
/XLE: J2.29 (XLE), U1.32 (XLE)
/XOE: J2.30 (XOE), U1.33 (XOE)
/XSTL: J2.28 (XSTL), U1.31 (XSTL)
GND: J1.2, J2.9 (VSS), J2.27 (VSS), J2.39 (VSS), J2.40 (VSS), J2.45 (VSS), U1.9 (VSS), U1.12 (VSS), U1.22 (VSS)
VDD: J2.3 (VDD), J2.8 (VDD), U1.5 (VDD), U1.11 (VDD)

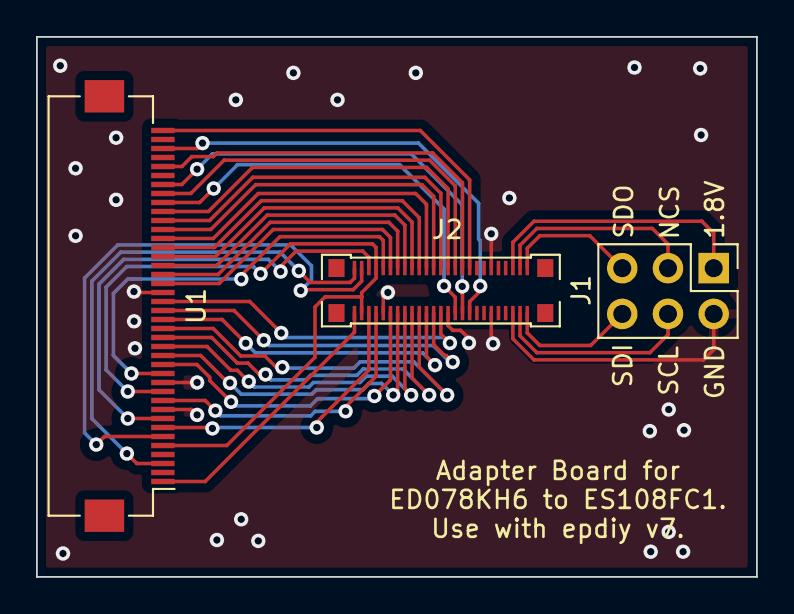
[picture p11: board ES108FC1_Connector.kicad_pcb from above]

Board: 2 copper layers, 40.0 x 30.0 mm, 3 parts (0 on the bottom side), 37 nets.
