seuros/epdiy-esp-idf-6/(notices)

Notices in the files:
hardware/epdiy-v7/epaper-breakout.kicad_sch:
License: CC-BY-SA-4.0
parts and their libraries:
Copyright 2016 Accelerated Designs. All rights reserved.
